elias-lange/Wetterstation/(commit log)

2020-10-26 Erste Version des Programmcodes.
2020-11-01 Code und Beschreibung um Luftdrucksensor erweitert.
2020-11-01 Auf allgemeinen ESP32 umgestellt.
