elias-lange/Wetterstation/(notices)

Notices in the files:
README.md:
License: Apache 2
